Aightech/drvAMC/README.md

# drvAMC

Simple library to ..............

# Building source code

To build the project run:
```bash
cd drvAMC
mkdir build && cd build
cmake .. && make
```

# Demonstration app

When the project have been built, you can run:
```bash
./drvAMC -h
```
to get the demonstration app usage.

# Example
Open the main.cpp file to get an example how to use the lib.
