Aightech/drvAMC/docs/AMC_RS485 Communication to DZ using MC1XDZ.pdf

## RS485 Communication to DZ using MC1XDZ

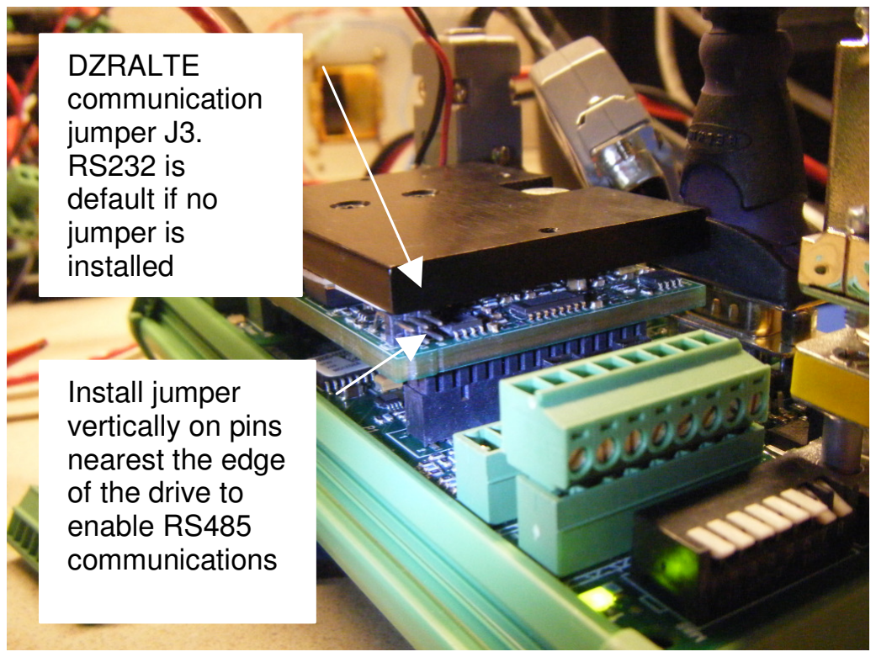
[picture p7: figure]
DZRALTE communication jumper J3. RS232 is default if no jumper is installed; Install jumper vertically on pins nearest the edge of the drive to enable RS485 communications
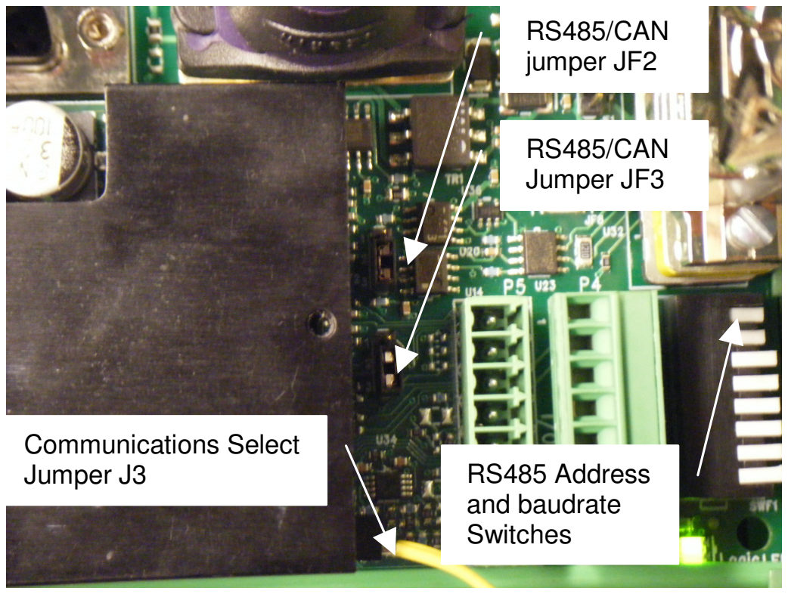
[picture p8: figure]
RS485/CAN jumper JF2; RS485/CAN Jumper JF3; Communications Select; Jumper J3; RS485 Address; and baudrate Switches
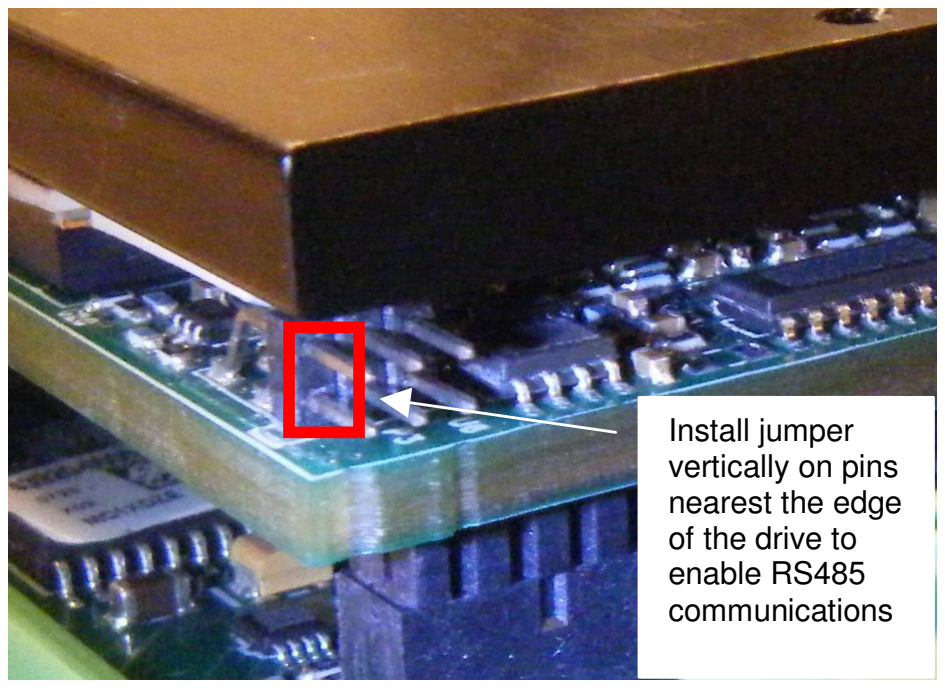
[picture p9: figure]
Install jumper vertically on pins nearest the edge of the drive to enable RS485 communications
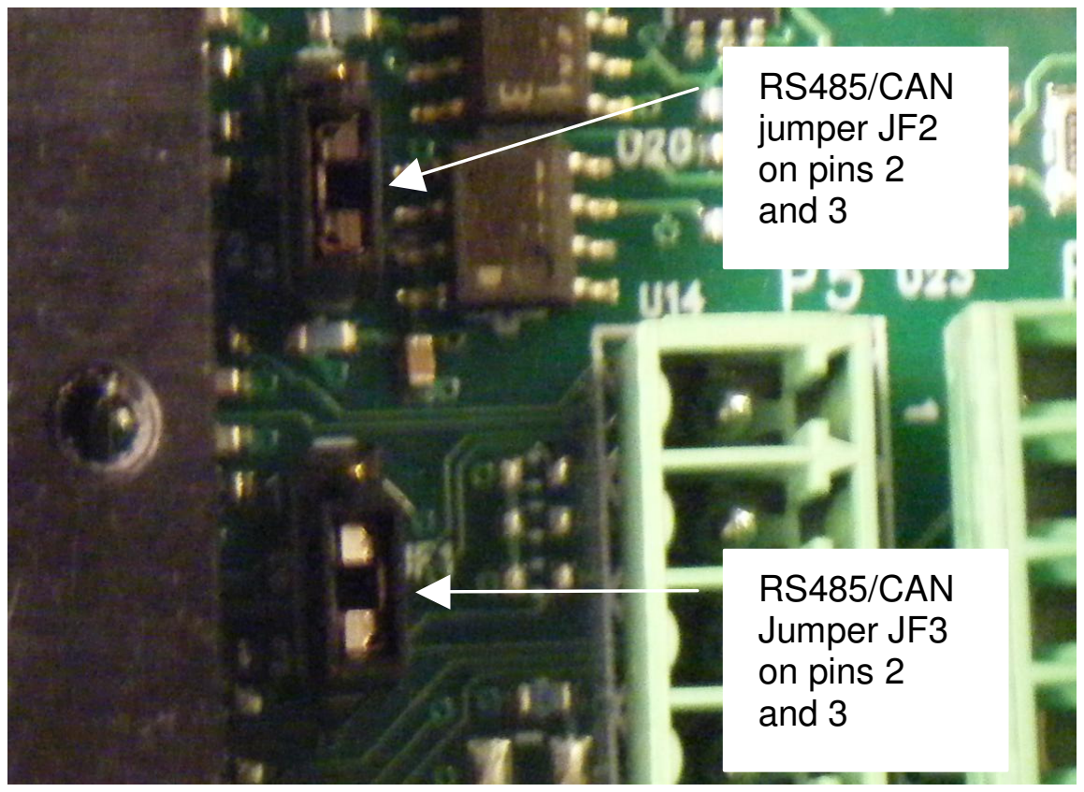
[picture p10: figure]
RS485/CAN jumper JF2 on pins 2 and 3; RS485/CAN Jumper JF3 on pins 2 and 3

Advanced Motion Controls • 3805 Calle Tecate Camarillo CA. 93012 • Tel: (805) 389-1935 • www.a-m-c.com

AN-002

## Introduction

The DZRALTE-012L080 servo drive supports RS485 communication in addition to the standard RS232 communication. The drive ships from the factory set for RS232 communication. Default communication parameters are 9600 baud and drive address
63.

## Configuring the DZRALTE for

RS485

In order for the drive to communicate via RS485, the RS485 selection jumper must be installed on the DZRALTE. The J3 jumper is pictured below on the DZRALTE mounted to a MC1XDZ.

### DZRALTE-012L080 and MC1XDZ

### Jumper Locations on MC1XDZ

Once the jumper is installed, the drive must be power cycled to enable RS485 communications. The default RS485 communication parameters are 9600 baud and address 63 respectively.

## Configuring the MC1XDZ for

RS485

The MC1XDZ mounting card must also be configured properly to support RS485 communication. The factory default is RS232 communication and CAN. To enable RS485 communication, jumpers JF2 and JF3 must be moved so that pins 2 and 3 are shorted together via the jumper. The factory default is RS232 communication with pins 1 and 2 of JF2 and JF3 shorted.

### Jumper Locations on MC1XDZ

### Jumper Settings on MC1XDZ

## RS485 Communication to DZ using MC1XDZ

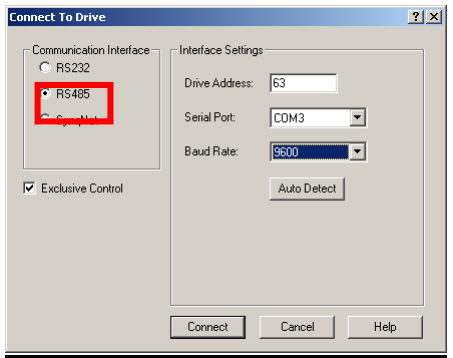
[picture p11: figure]

Advanced Motion Controls • 3805 Calle Tecate Camarillo CA. 93012 • Tel: (805) 389-1935 • www.a-m-c.com

AN-002

Unlike RS232 mode, RS485 mode supports the selection of drive address and baudrate via hardware using the switches on the MC1XDZ. The factory default is software addressing with all switches off. If switch changes are made, the drive must be power cycled before the changes will take effect.

## RS485 Connection via DriveWare

If hardware is properly configured, Drive Ware can communicate via RS485 to the drive. At the communications screen, select RS485 and make sure the drive address and baudrate match. Note: if hardware addressing and baudrate are used via the switches, make sure the values are properly entered here or communication will not work.

Once RS485 connection is established, the RS485 baudrate and drive address can be changed by pressing the connect icon on the tool bar and entering new values into the connect to drive dialog then pressing Connect.

Verify that the new baudrate took effect by looking at the bottom center of the drive ware window for connection status

Make sure to save any changes to Non-Volatile memory by using the toolbar icon or selecting Drive -> Store to Drive option from the main menu.

NOTE: The RS485 communication parameters are independent of RS232 parameters. If the drive is returned to RS232 mode, the original communication parameters that were set in RS232 mode will take affect. The factory default is to set both sets of parameters identically, but in practice it is possible to have two different sets of parameters.
