Aightech/drvAMC/models/v2/Assem1.SLDASM

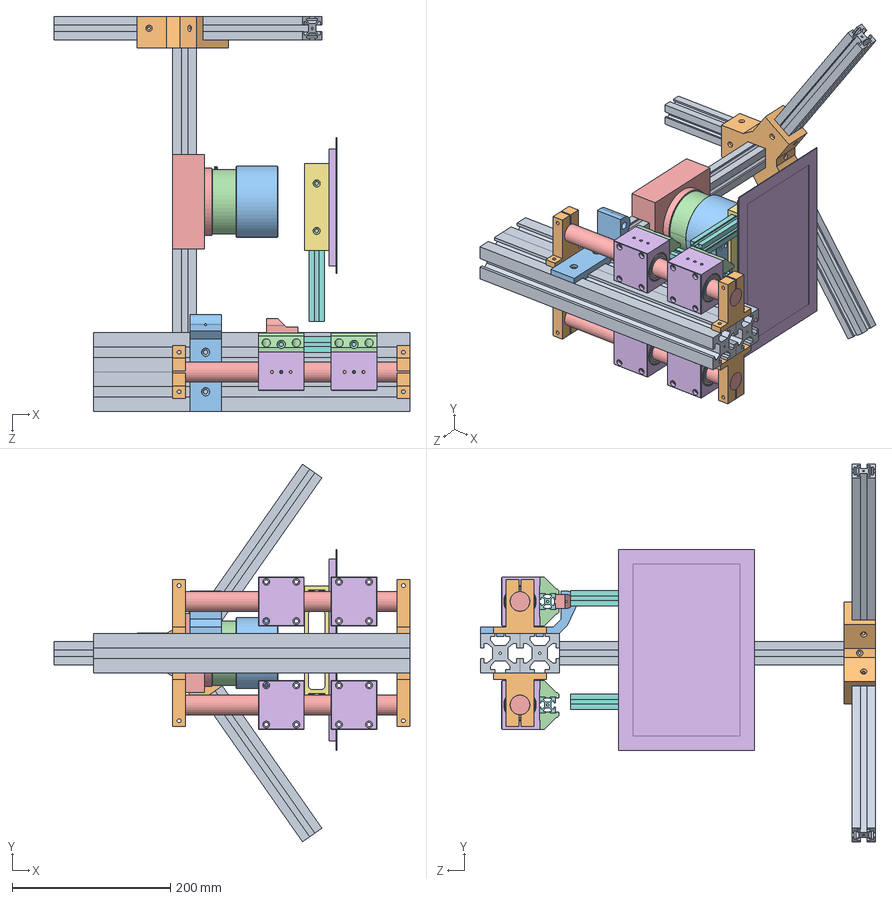
[picture p30: CAD file, 2022-02-02, last stored version]
models/v2/Assem1.SLDASM
450.0 x 478.0 x 500.0 mm
profile30 x 4
foot_link
AVM90-30-core-Sketch.STEP
AVM90-30-Coil-Sketch.STEP
shaft x 2
S8025P02.step x 4
S3025021.step x 4
S3025022.step x 4
S3025023.step x 4
S3025024.step x 4
S3025025.step x 4
S3025026.step x 4
Part15^Assem1
screen
screenHolder
profile20 x 4
profile50 x 2
guide_holder x 4
lvdt_holderSLDPRT
bracke-holder-v2 x 8
lvdt_holderP2
