Aightech/drvAMC/models/voice_coil.SLDASM

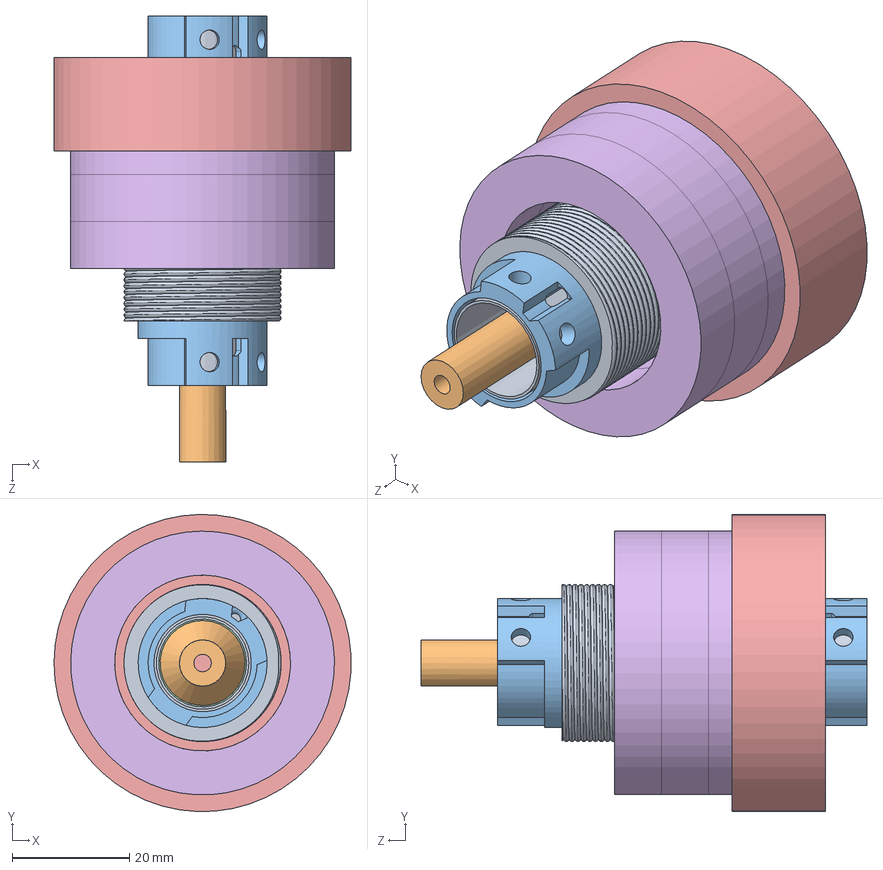
[picture p31: CAD file, 2022-02-02, last stored version]
models/voice_coil.SLDASM
50.7 x 50.7 x 76.0 mm
solenoid
magnet
coil_end x 2
mag x 4
magnet_holder
magnet_large x 4
