Aightech/drvAMC/models/Assem1.SLDASM

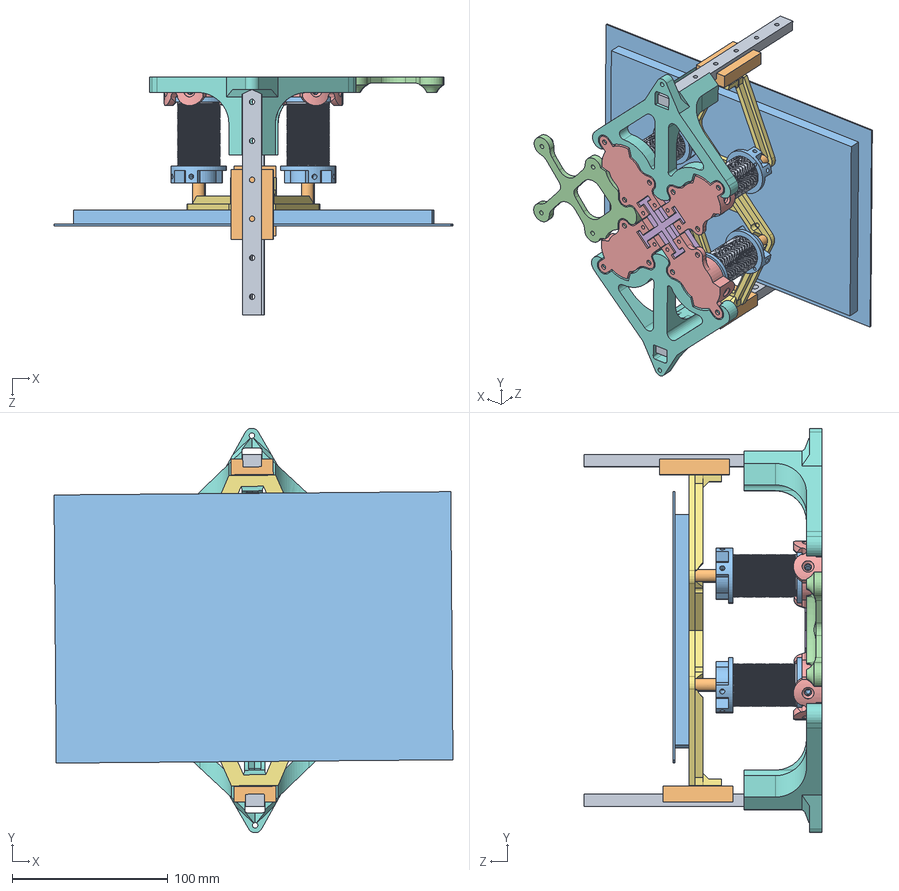
[picture p32: CAD file, 2022-02-02, last stored version]
models/Assem1.SLDASM
255.9 x 259.4 x 152.8 mm
solenoid x 4
magnet x 4
coil_end x 8
mag x 16
coil_holder x 4
frame
screen_holder
guide x 2
slide_guide x 2
slider x 2
screen
rpy_linkv2
