Aightech/drvAMC/models/v2/Assem2.SLDASM

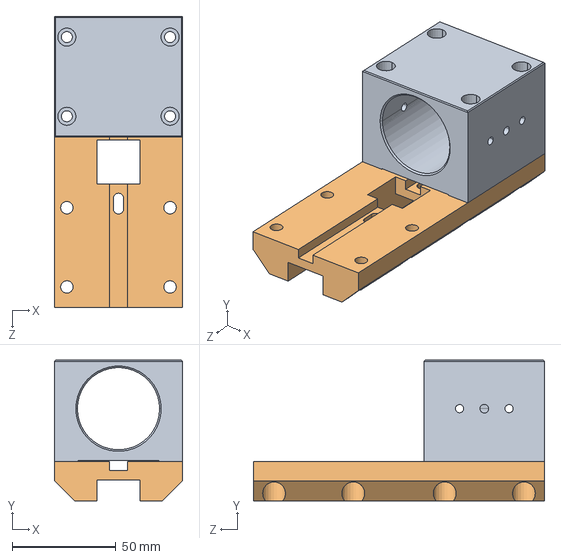
[picture p33: CAD file, 2022-02-02, last stored version]
models/v2/Assem2.SLDASM
61.7 x 67.6 x 140.0 mm
S8025P02
bracke-holder
