Aightech/drvAMC/models/new/magnet_holder.SLDPRT

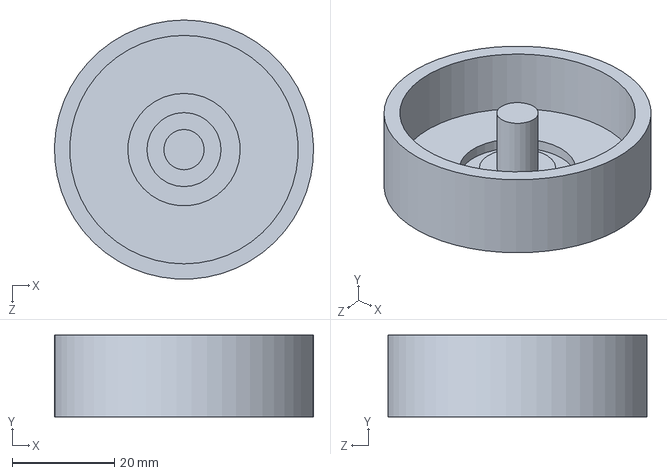
[picture p34: CAD file, 2022-02-02, last stored version]
models/new/magnet_holder.SLDPRT
50.7 x 16.0 x 50.7 mm
