Aightech/drvAMC/models/slider.SLDPRT

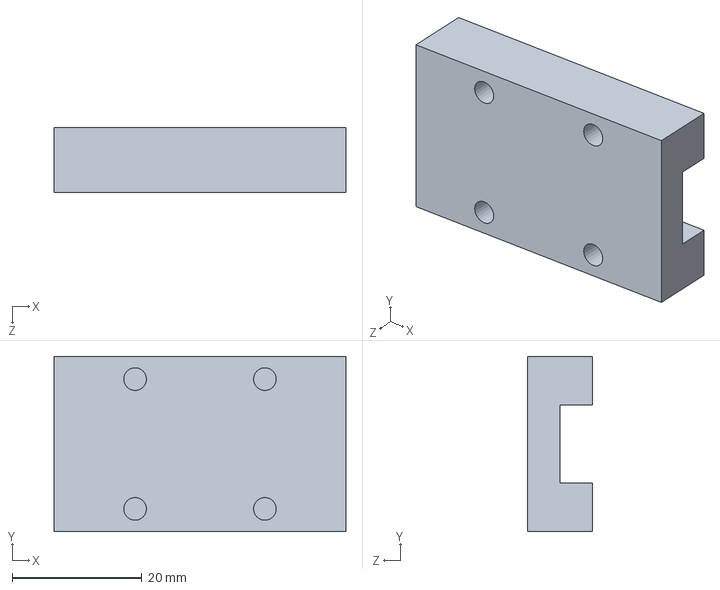
[picture p35: CAD file, 2022-02-02, last stored version]
models/slider.SLDPRT
45.0 x 27.0 x 10.0 mm
