Aightech/drvAMC/models/v2/screen.SLDPRT

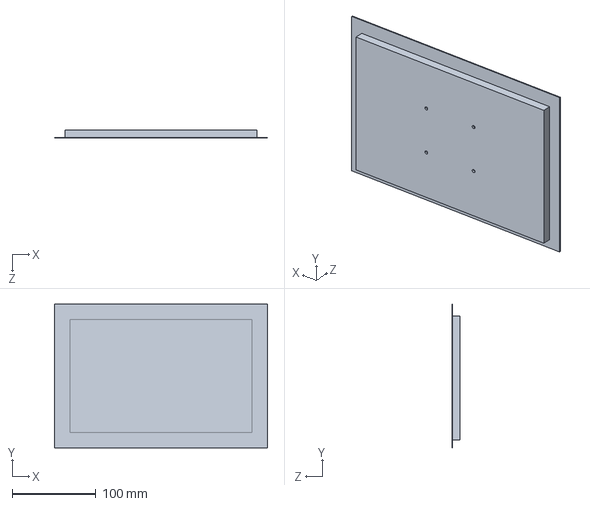
[picture p36: CAD file, 2022-02-02, last stored version]
models/v2/screen.SLDPRT
254.5 x 172.0 x 10.0 mm
