Aightech/drvAMC/models/mag.SLDPRT

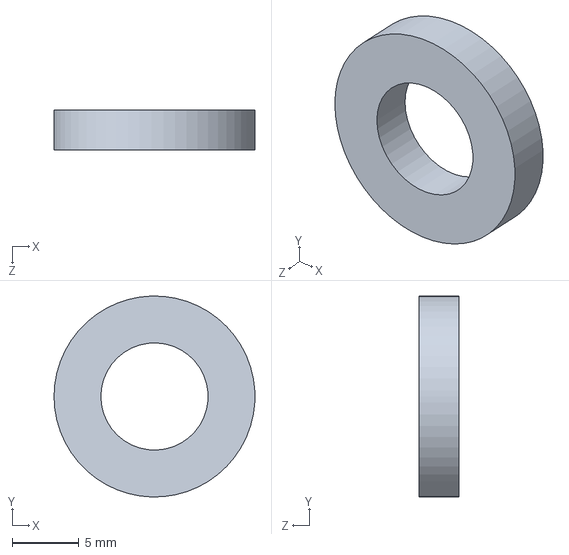
[picture p37: CAD file, 2022-02-02, last stored version]
models/mag.SLDPRT
15.0 x 15.0 x 3.00 mm
