Aightech/drvAMC/models/v2/end mount.SLDPRT

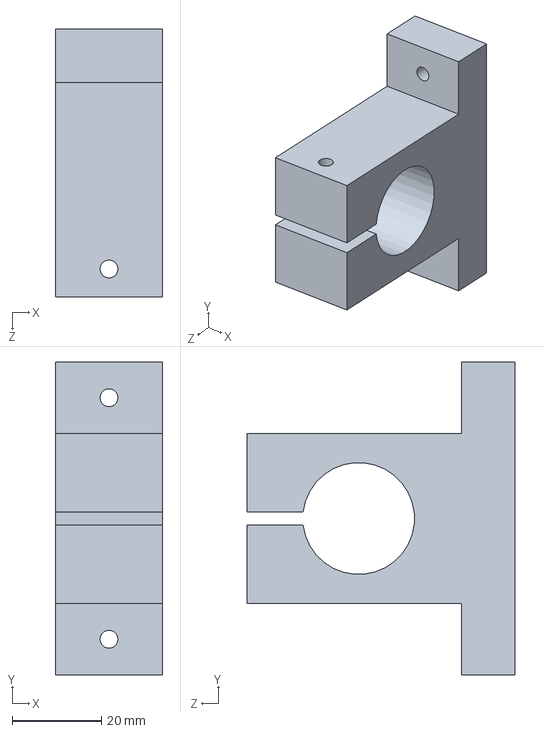
[picture p38: CAD file, 2022-02-02, last stored version]
models/v2/end mount.SLDPRT
24.0 x 70.0 x 60.0 mm
