Aightech/drvAMC/models/coil_end.SLDPRT

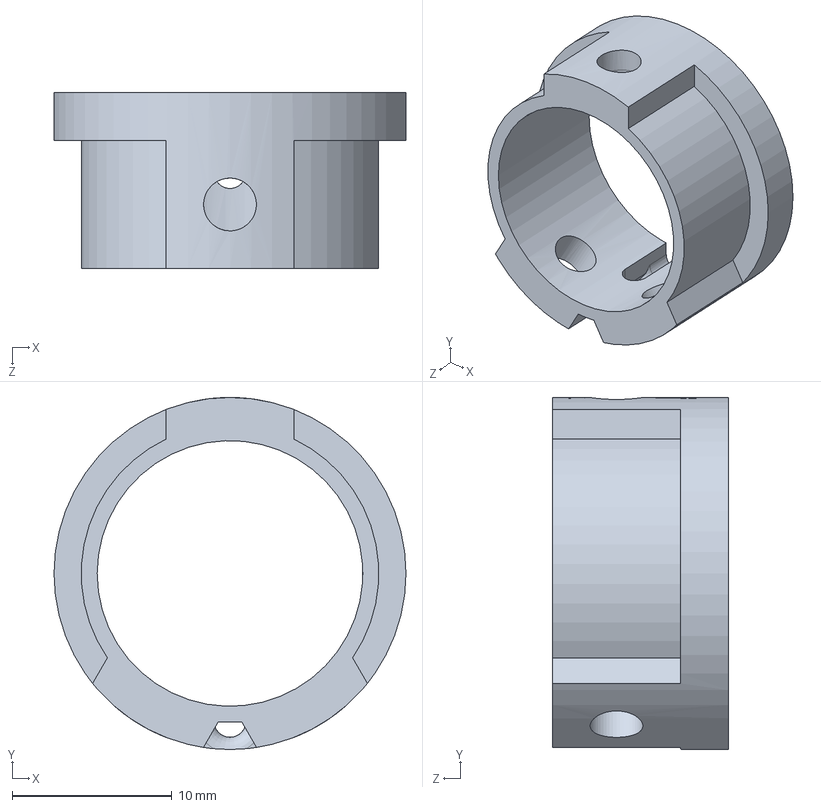
[picture p39: CAD file, 2022-02-02, last stored version]
models/coil_end.SLDPRT
22.0 x 22.0 x 11.0 mm
