Aightech/drvAMC/models/v2/lvdt_holderSLDPRT.SLDPRT

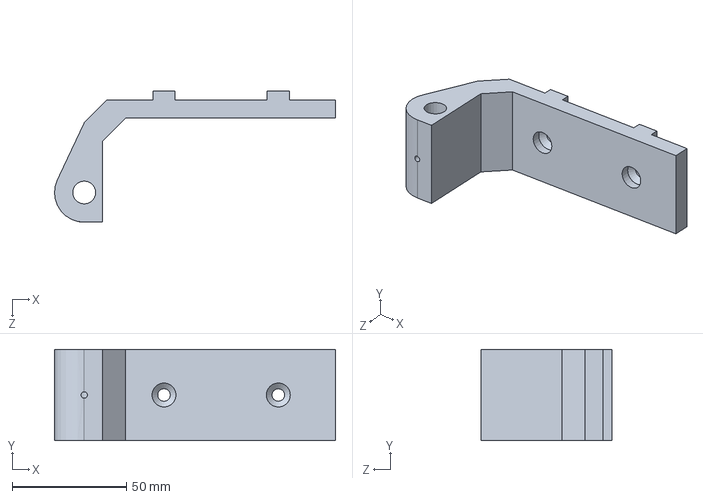
[picture p40: CAD file, 2022-02-02, last stored version]
models/v2/lvdt_holderSLDPRT.SLDPRT
122.9 x 40.0 x 57.5 mm
