Aightech/drvAMC/models/irsensor_cache.SLDPRT

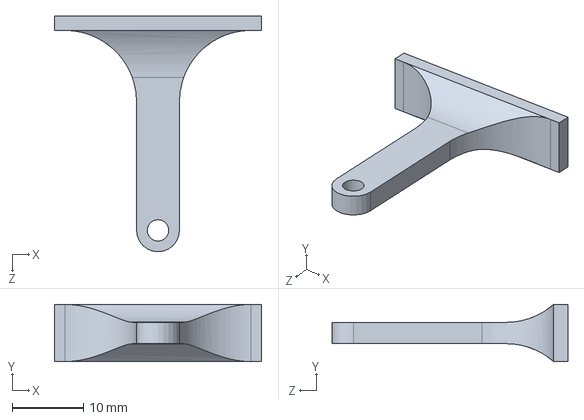
[picture p41: CAD file, 2022-02-02, last stored version]
models/irsensor_cache.SLDPRT
29.0 x 8.00 x 33.0 mm
