Aightech/drvAMC/models/v2/S8025E02.STEP

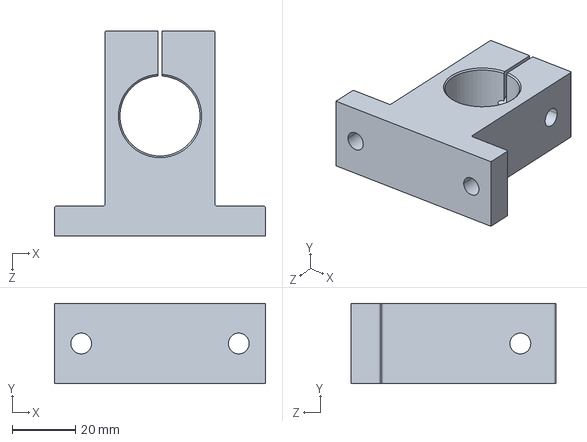
[picture p42: CAD file, 2022-02-02, last stored version]
models/v2/S8025E02.STEP
67.0 x 25.4 x 65.1 mm
