Aightech/drvAMC/models/screen_holder.SLDPRT

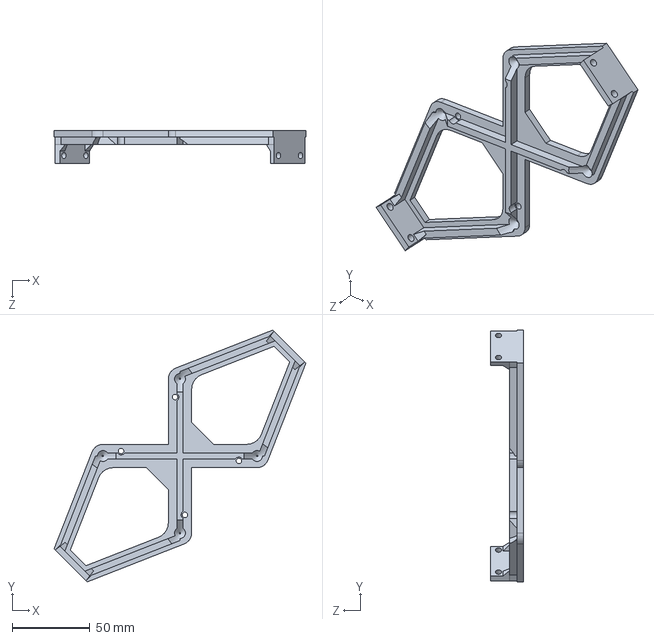
[picture p43: CAD file, 2022-02-02, last stored version]
models/screen_holder.SLDPRT
161.9 x 161.9 x 21.0 mm
