Aightech/drvAMC/models/v2/screenHolderV2_right.STL

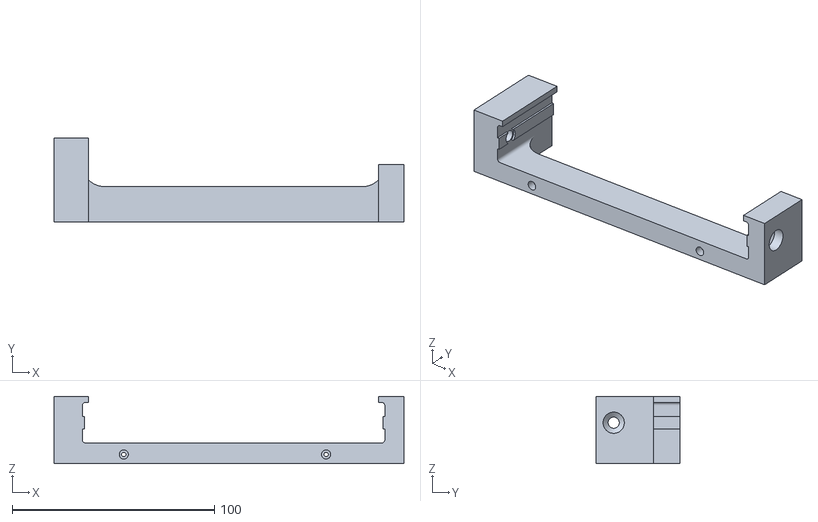
[picture p44: CAD file, 2022-02-02, last stored version]
models/v2/screenHolderV2_right.STL
173.0 x 41.5 x 33.2
