Aightech/drvAMC/models/irsensor_tube.SLDPRT

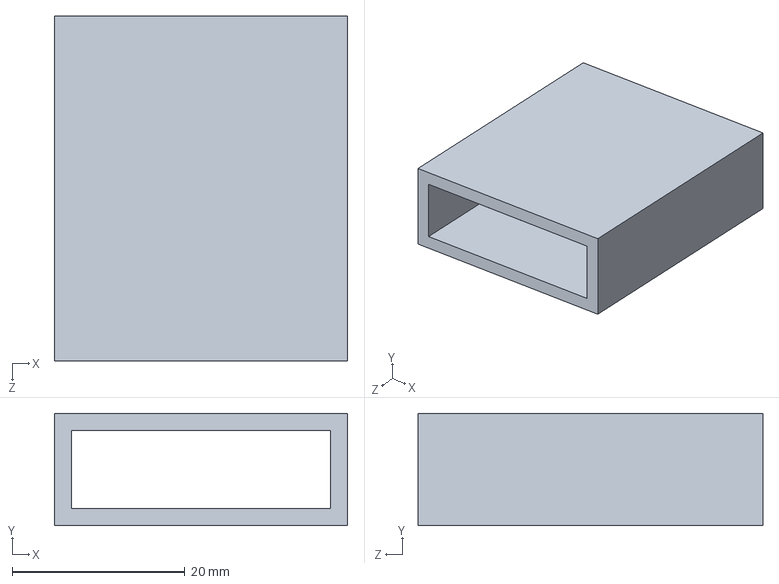
[picture p45: CAD file, 2022-02-02, last stored version]
models/irsensor_tube.SLDPRT
34.0 x 13.0 x 40.0 mm
