Aightech/drvAMC/models/v2/profile40.SLDPRT

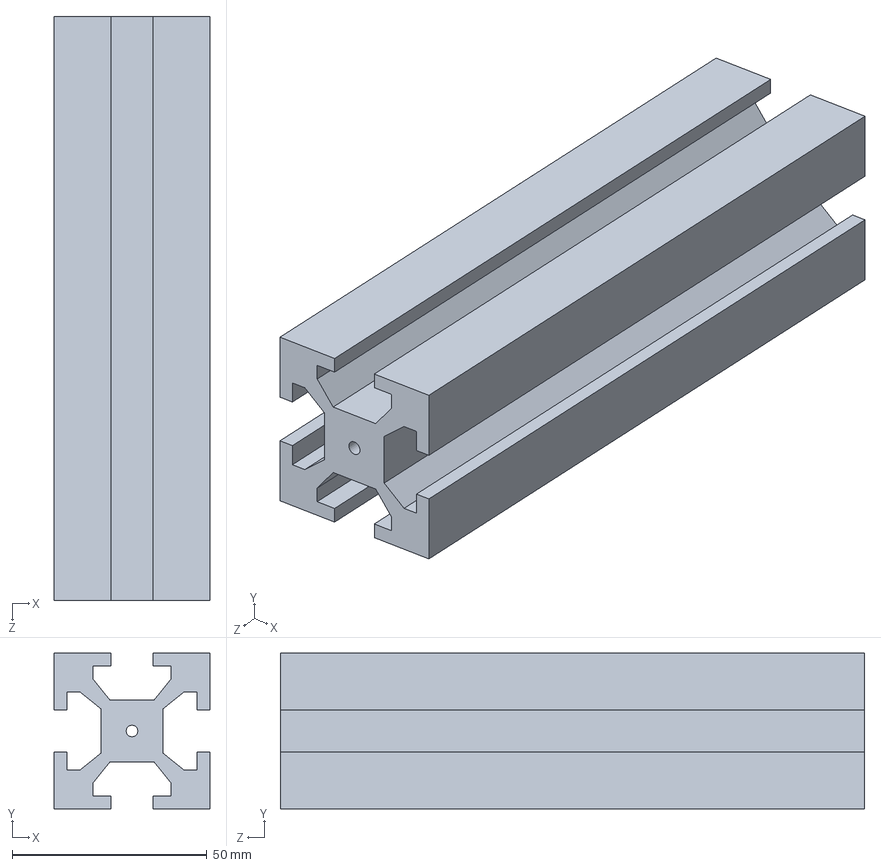
[picture p46: CAD file, 2022-02-02, last stored version]
models/v2/profile40.SLDPRT
40.0 x 40.0 x 150.0 mm
