Aightech/drvAMC/models/rpy_supp.SLDPRT

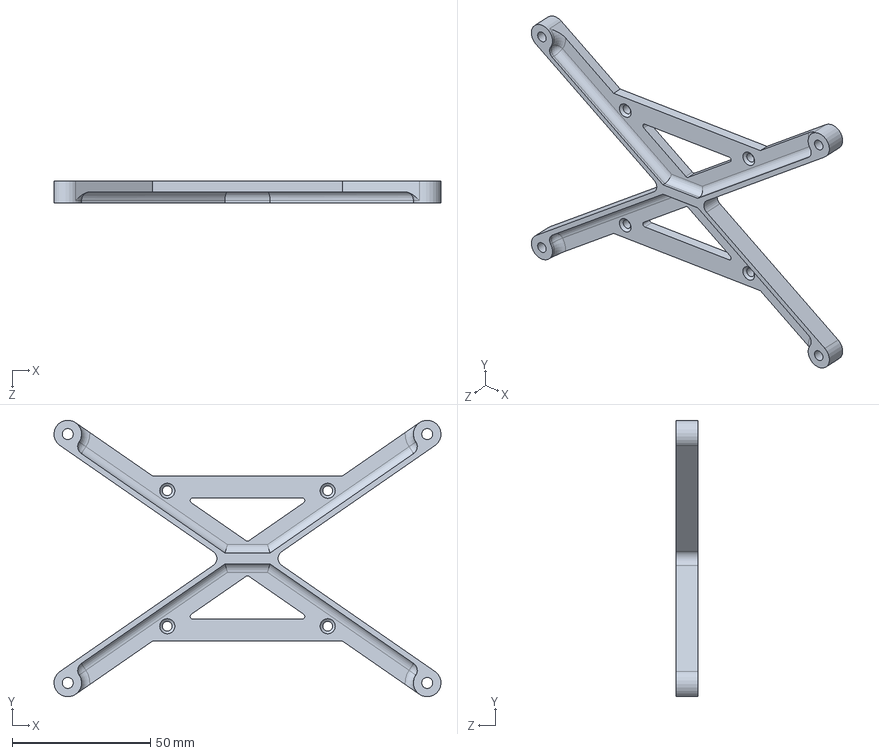
[picture p47: CAD file, 2022-02-02, last stored version]
models/rpy_supp.SLDPRT
140.0 x 100.0 x 8.00 mm
