Aightech/drvAMC/models/v2/screenDriverHolder.SLDPRT

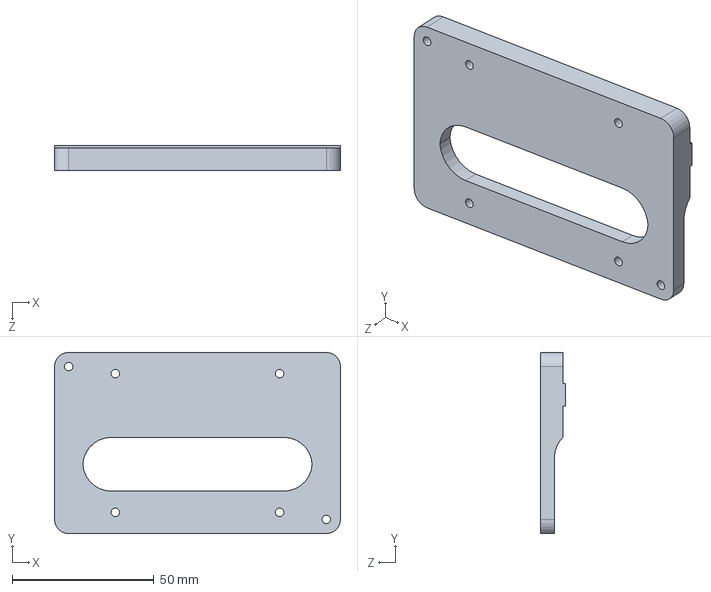
[picture p48: CAD file, 2022-02-02, last stored version]
models/v2/screenDriverHolder.SLDPRT
101.0 x 64.0 x 9.00 mm
