Aightech/drvAMC/models/magnet_large.SLDPRT

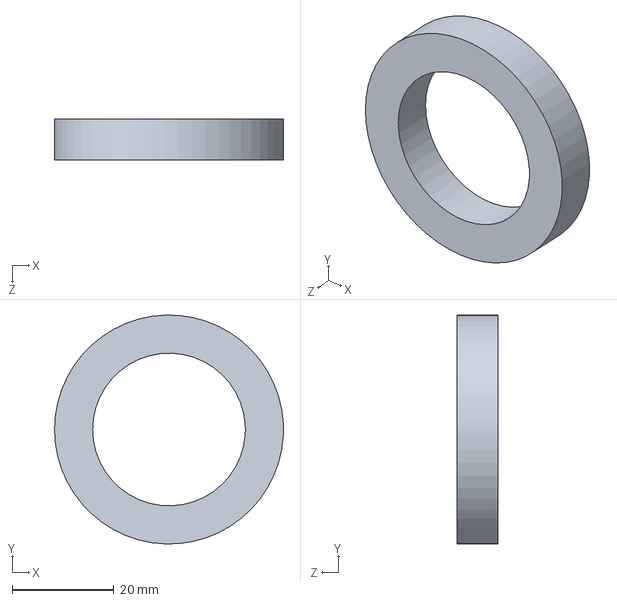
[picture p49: CAD file, 2022-02-02, last stored version]
models/magnet_large.SLDPRT
45.0 x 45.0 x 8.00 mm
