Aightech/drvAMC/models/v2/shaft.SLDPRT

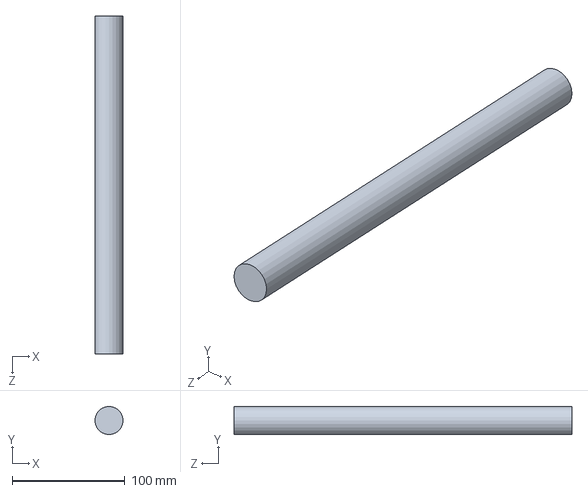
[picture p50: CAD file, 2022-02-02, last stored version]
models/v2/shaft.SLDPRT
25.0 x 25.0 x 300.0 mm
