Aightech/drvAMC/models/solenoid.SLDPRT

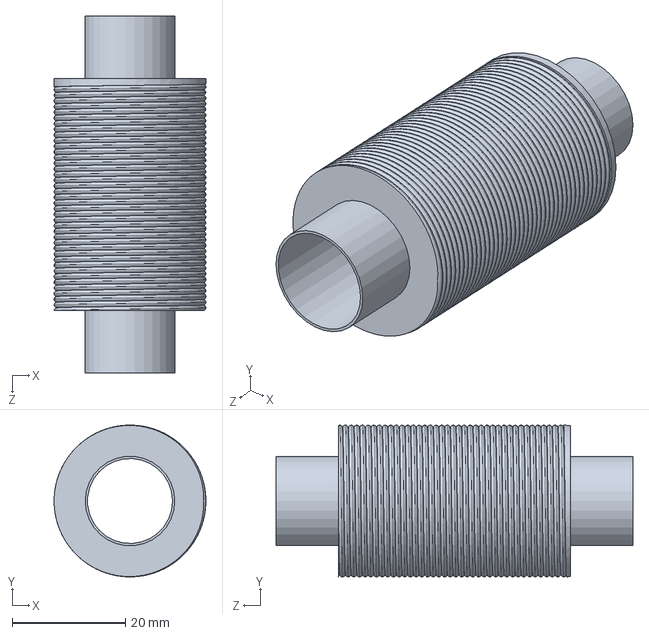
[picture p51: CAD file, 2022-02-02, last stored version]
models/solenoid.SLDPRT
26.8 x 26.8 x 63.0 mm
