Aightech/drvAMC/models/v2/motorMovingHolder.SLDPRT

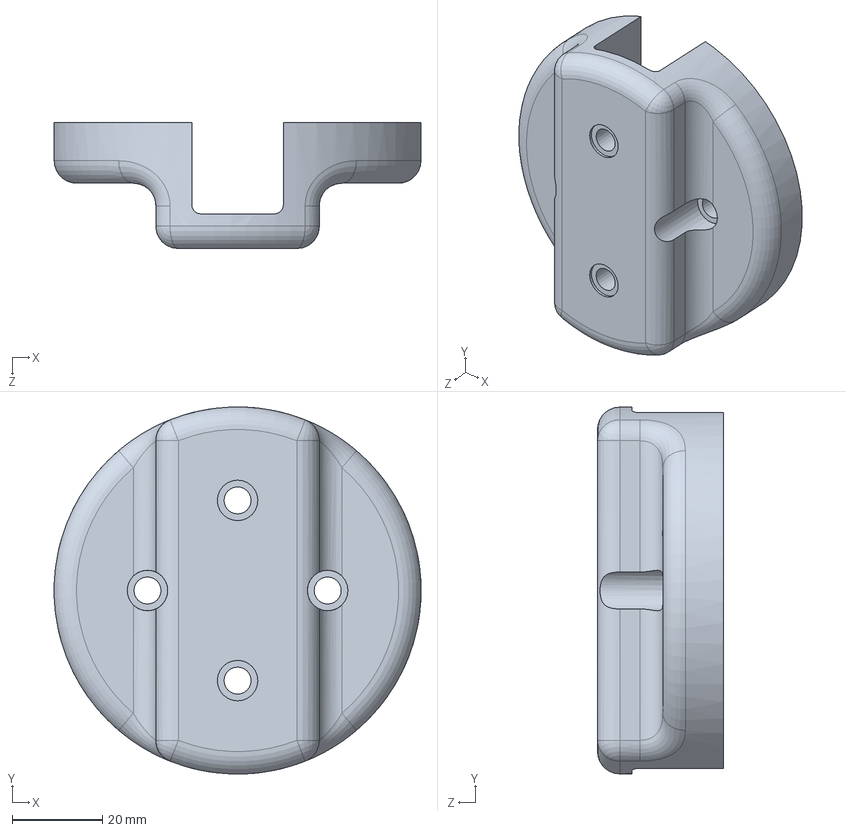
[picture p52: CAD file, 2022-02-02, last stored version]
models/v2/motorMovingHolder.SLDPRT
81.5 x 81.5 x 28.0 mm
