Aightech/drvAMC/models/rpy_link.SLDPRT

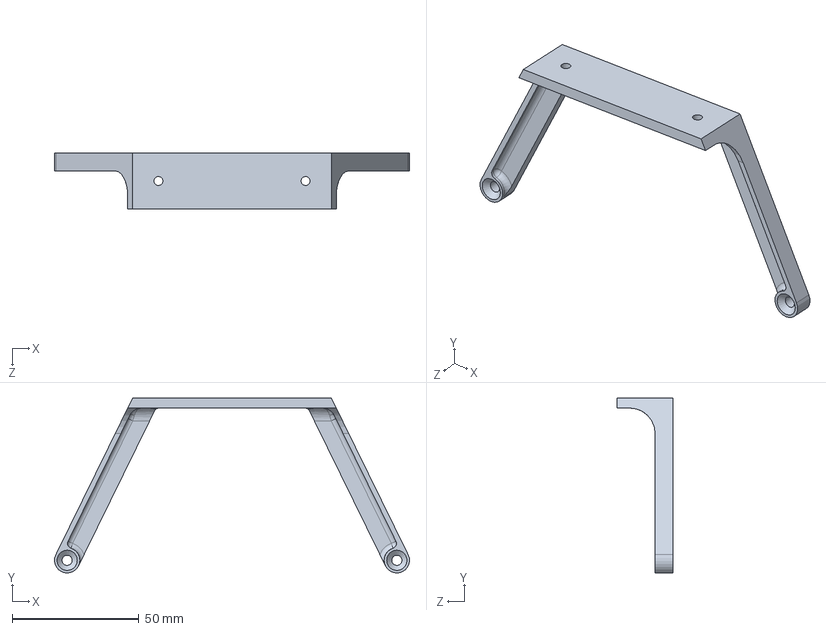
[picture p54: CAD file, 2022-02-02, last stored version]
models/rpy_link.SLDPRT
140.0 x 69.0 x 22.0 mm
