Aightech/drvAMC/models/v2/screenHolder.SLDPRT

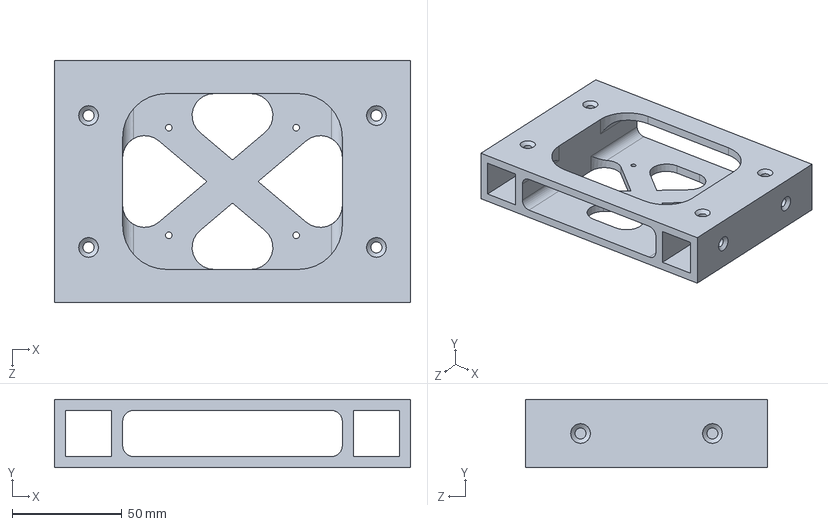
[picture p55: CAD file, 2022-02-02, last stored version]
models/v2/screenHolder.SLDPRT
162.0 x 31.0 x 110.0 mm
