Aightech/drvAMC/models/v2/foot_link.SLDPRT

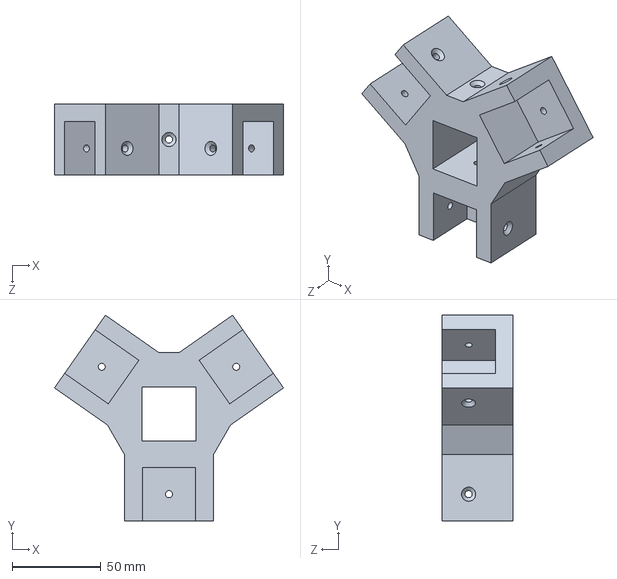
[picture p56: CAD file, 2022-02-02, last stored version]
models/v2/foot_link.SLDPRT
129.0 x 115.9 x 40.0 mm
