Aightech/drvAMC/models/guide.SLDPRT

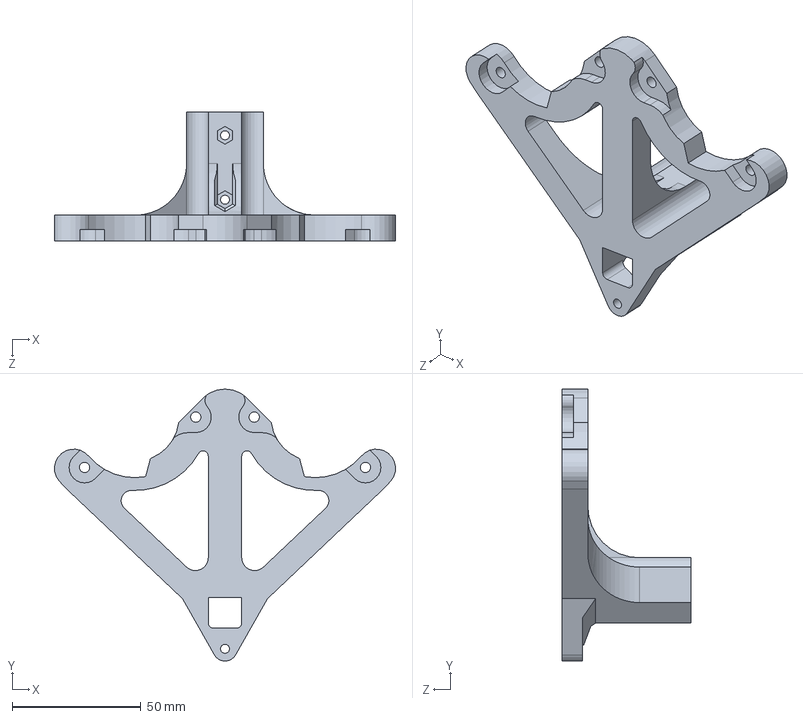
[picture p57: CAD file, 2022-02-02, last stored version]
models/guide.SLDPRT
132.4 x 105.6 x 50.0 mm
