Aightech/drvAMC/models/v2/screenHolderV2_left.STL

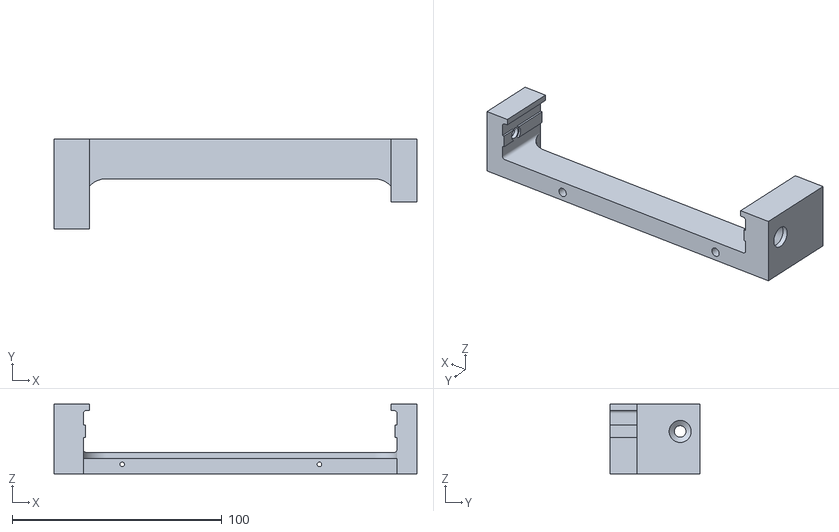
[picture p58: CAD file, 2022-02-02, last stored version]
models/v2/screenHolderV2_left.STL
173.0 x 43.0 x 33.2
