Aightech/drvAMC/models/rpy_linkv2.SLDPRT

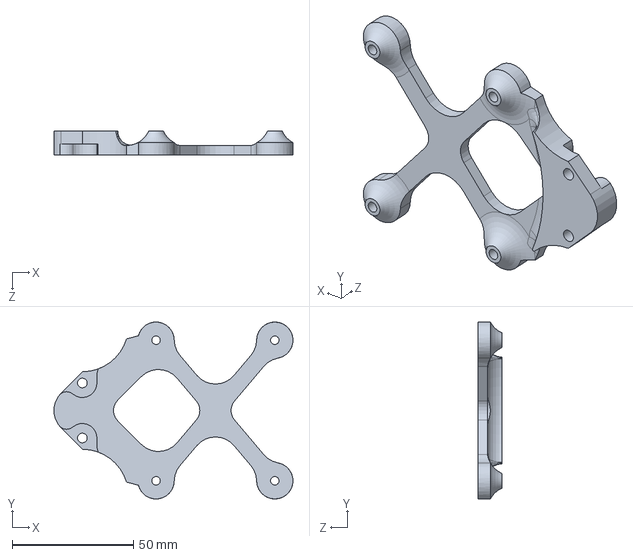
[picture p59: CAD file, 2022-02-02, last stored version]
models/rpy_linkv2.SLDPRT
98.6 x 73.0 x 10.0 mm
