Aightech/drvAMC/models/v2/driverHolder.SLDPRT

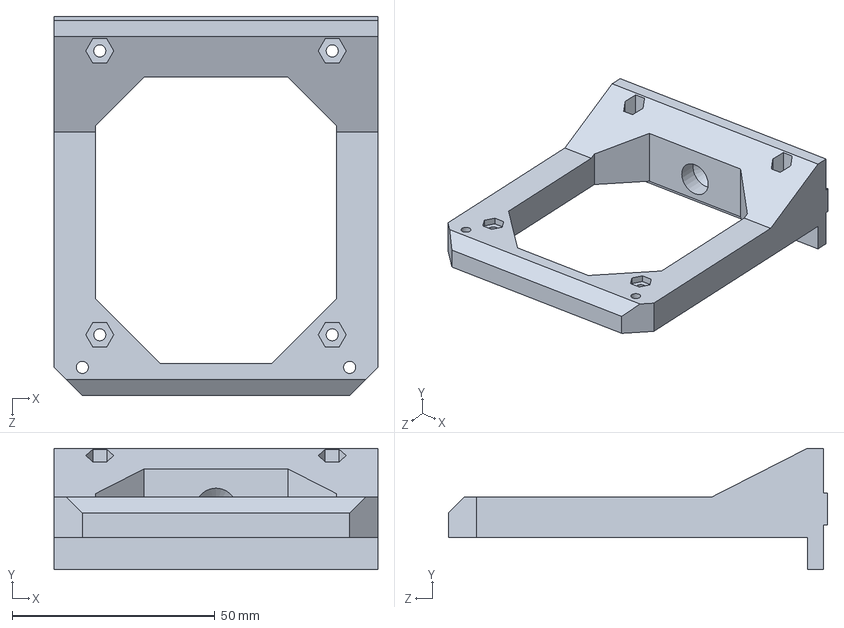
[picture p60: CAD file, 2022-02-02, last stored version]
models/v2/driverHolder.SLDPRT
80.0 x 30.0 x 93.7 mm
