Aightech/drvAMC/models/ir_top.SLDPRT

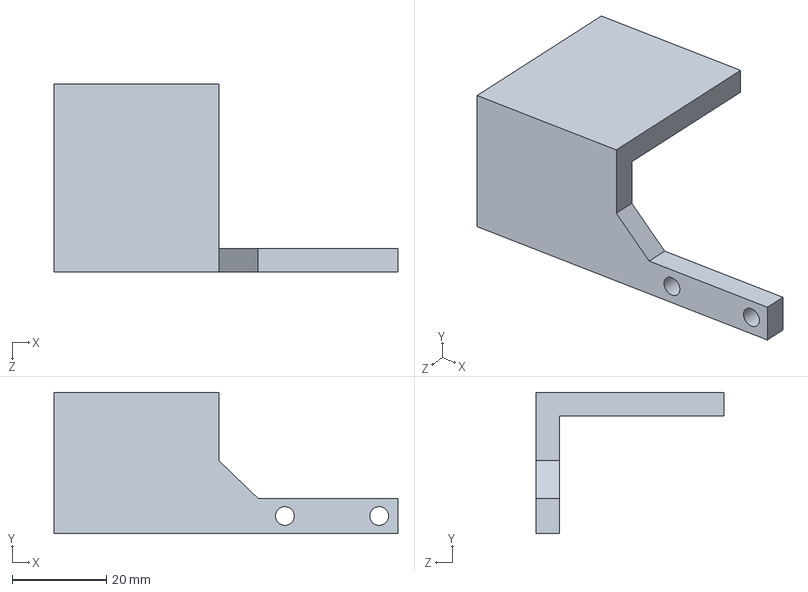
[picture p61: CAD file, 2022-02-02, last stored version]
models/ir_top.SLDPRT
73.0 x 30.0 x 40.0 mm
