Aightech/drvAMC/models/v2/bracket.SLDPRT

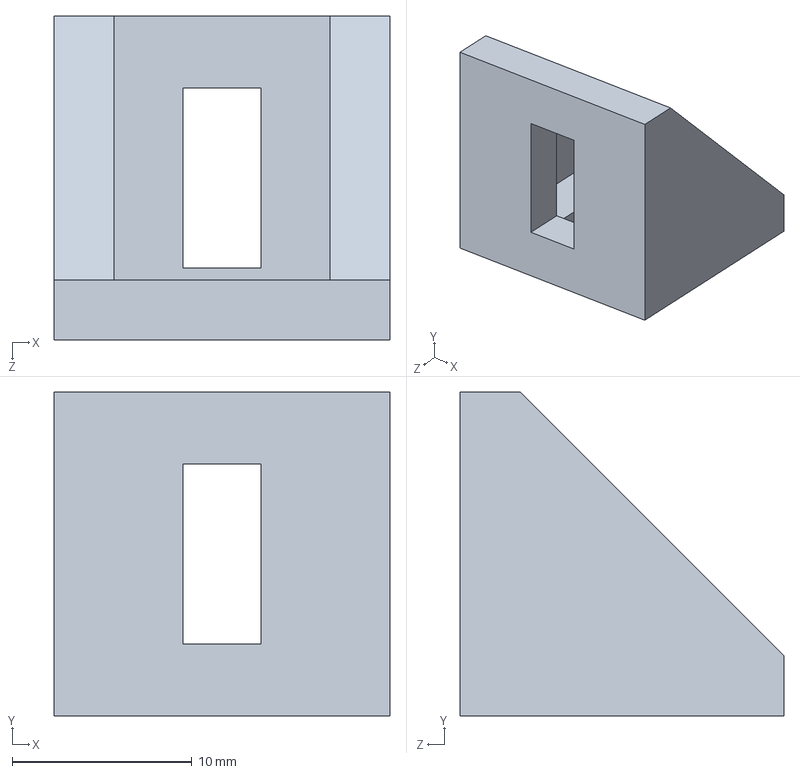
[picture p62: CAD file, 2022-02-02, last stored version]
models/v2/bracket.SLDPRT
18.7 x 18.0 x 18.0 mm
