Aightech/drvAMC/models/frame.SLDPRT

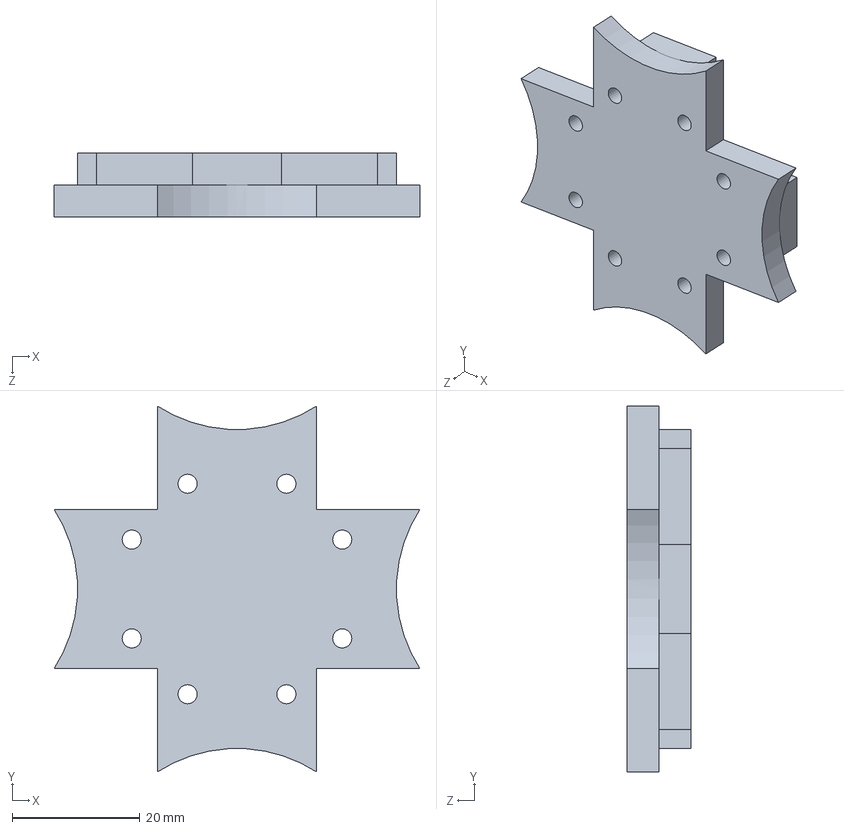
[picture p63: CAD file, 2022-02-02, last stored version]
models/frame.SLDPRT
57.4 x 57.4 x 10.0 mm
