Aightech/drvAMC/models/v2/screenHolderV2.SLDPRT

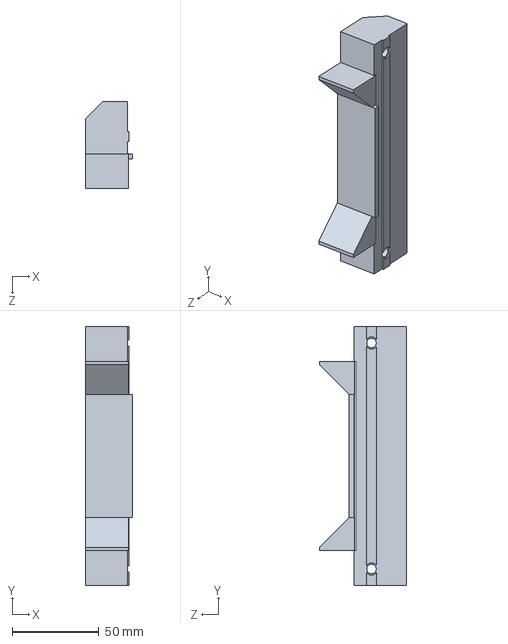
[picture p64: CAD file, 2022-02-02, last stored version]
models/v2/screenHolderV2.SLDPRT
27.0 x 149.0 x 50.2 mm
