Aightech/drvAMC/models/v2/profile50.SLDPRT

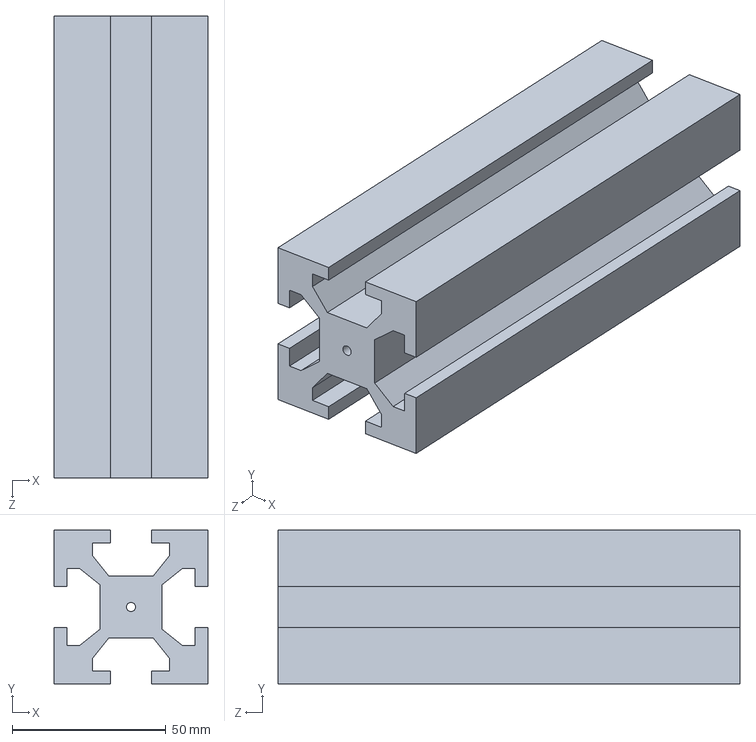
[picture p65: CAD file, 2022-02-02, last stored version]
models/v2/profile50.SLDPRT
50.0 x 50.0 x 150.0 mm
