Aightech/drvAMC/models/coil_holder.SLDPRT

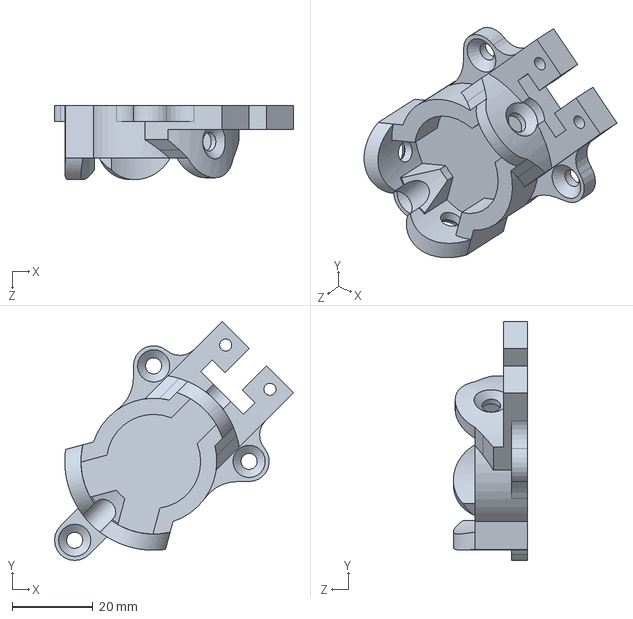
[picture p66: CAD file, 2022-02-02, last stored version]
models/coil_holder.SLDPRT
59.2 x 59.2 x 18.4 mm
