Aightech/drvAMC/models/v2/motorHolder.SLDPRT

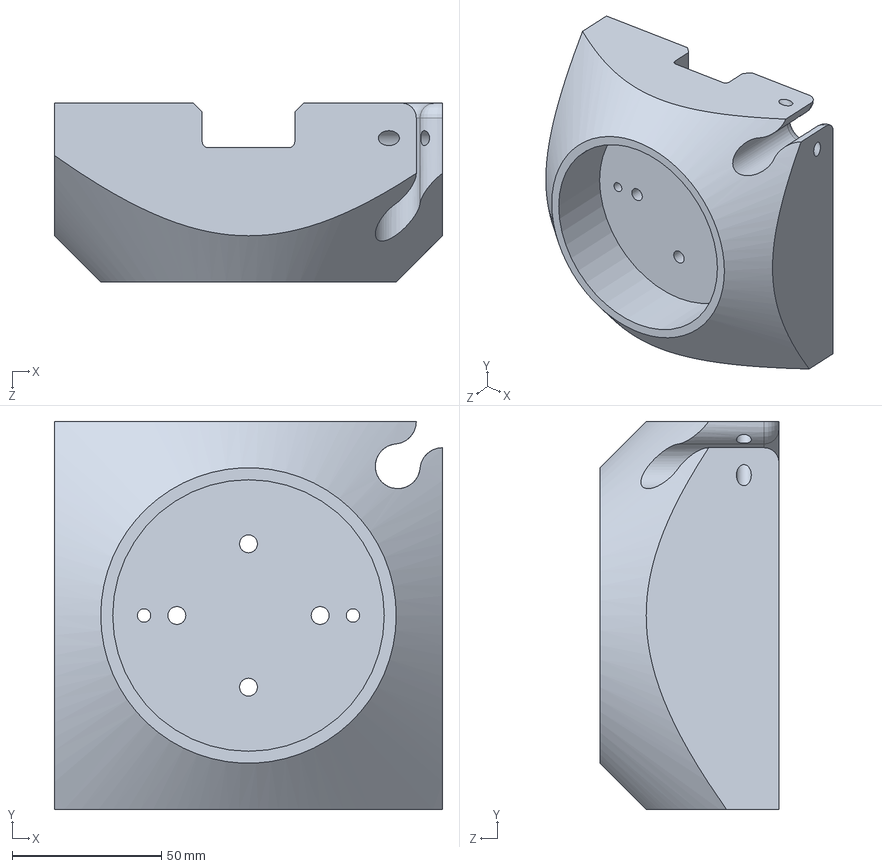
[picture p67: CAD file, 2022-02-02, last stored version]
models/v2/motorHolder.SLDPRT
130.0 x 130.0 x 60.0 mm
