Aightech/drvAMC/models/slide_guide.SLDPRT

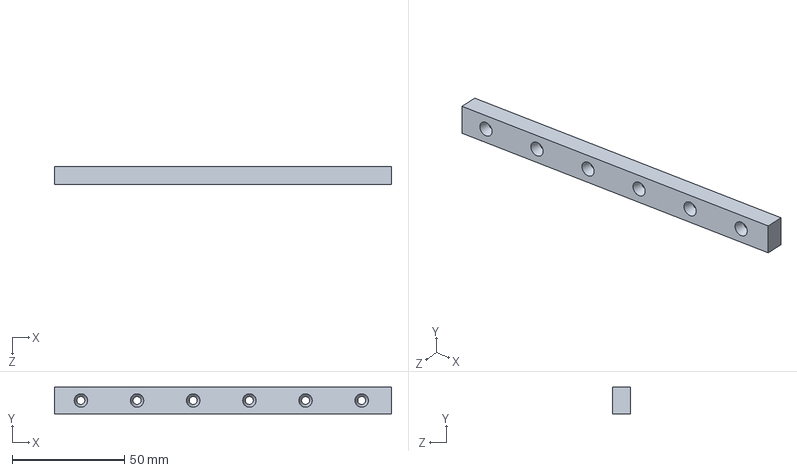
[picture p68: CAD file, 2022-02-02, last stored version]
models/slide_guide.SLDPRT
150.0 x 12.0 x 8.00 mm
