Aightech/drvAMC/models/v2/AVM90-30.STEP

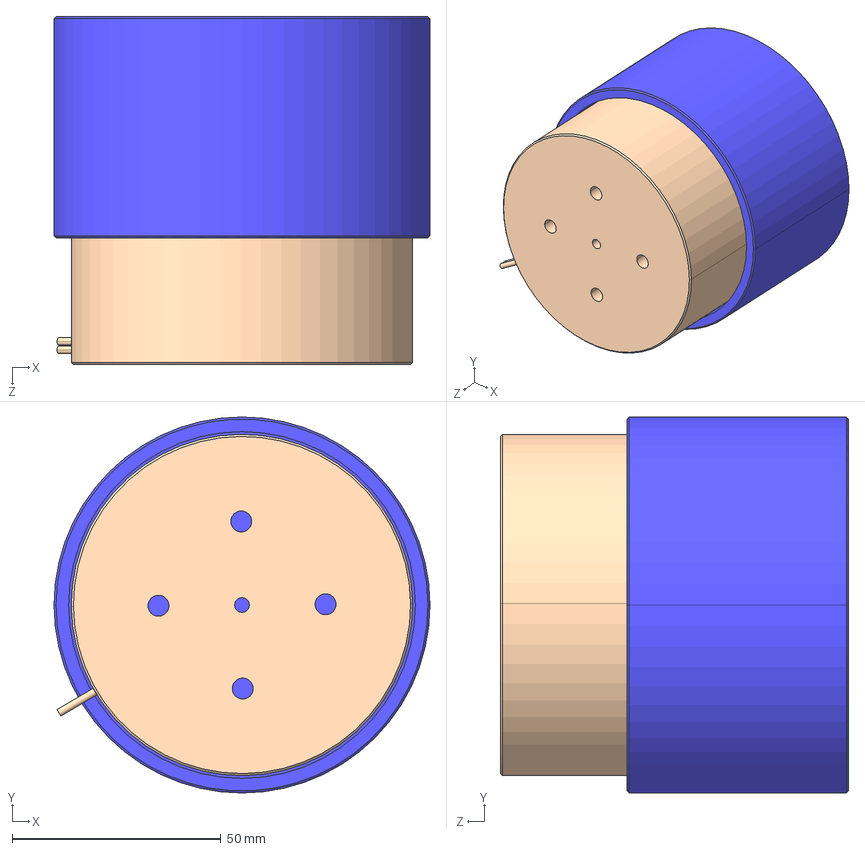
[picture p69: CAD file, 2022-02-02, last stored version]
models/v2/AVM90-30.STEP
90.0 x 90.0 x 83.3 mm
AVM90-30-core-Sketch
AVM90-30-Coil-Sketch
