Aightech/drvAMC/models/magnet.SLDPRT

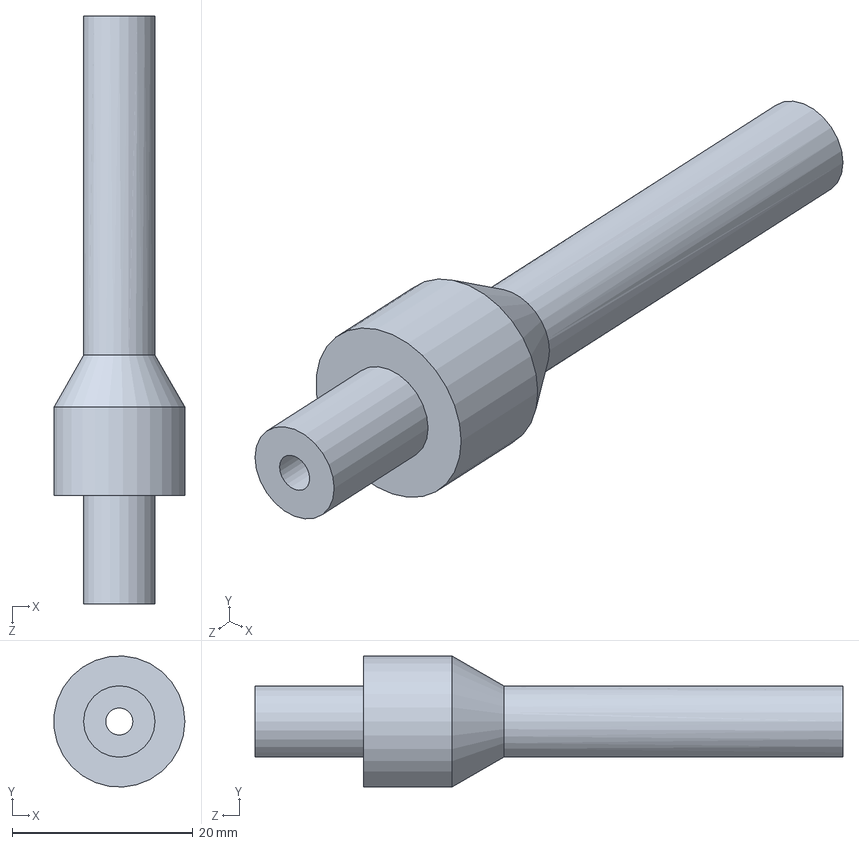
[picture p70: CAD file, 2022-02-02, last stored version]
models/magnet.SLDPRT
14.5 x 14.5 x 65.0 mm
