Aightech/drvAMC/models/v2/bracke-holder-v2.SLDPRT

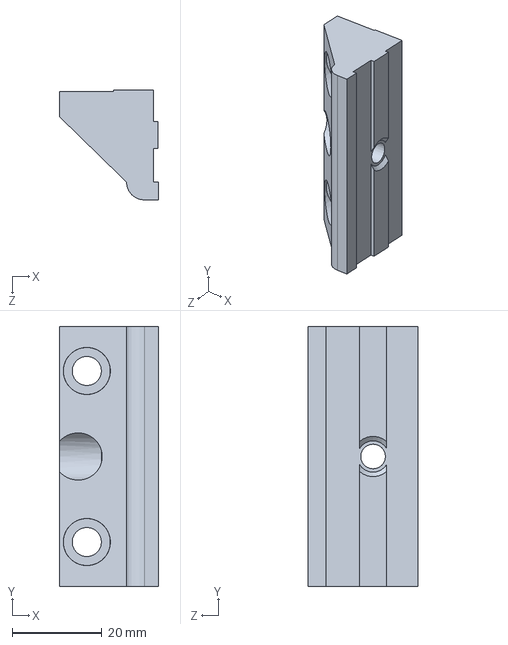
[picture p71: CAD file, 2022-02-02, last stored version]
models/v2/bracke-holder-v2.SLDPRT
22.0 x 57.9 x 24.5 mm
