Aightech/drvAMC/models/v2/carter.SLDPRT

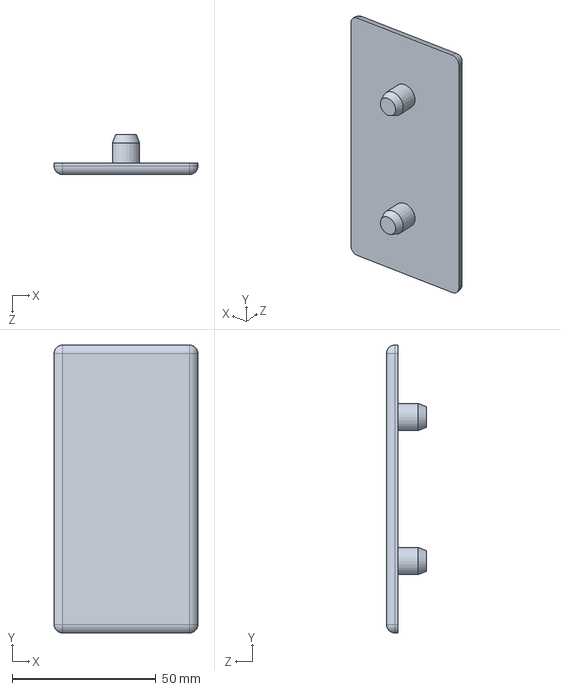
[picture p72: CAD file, 2022-02-02, last stored version]
models/v2/carter.SLDPRT
50.0 x 100.0 x 14.0 mm
