Aightech/drvAMC/models/v2/bracke-holder.SLDPRT

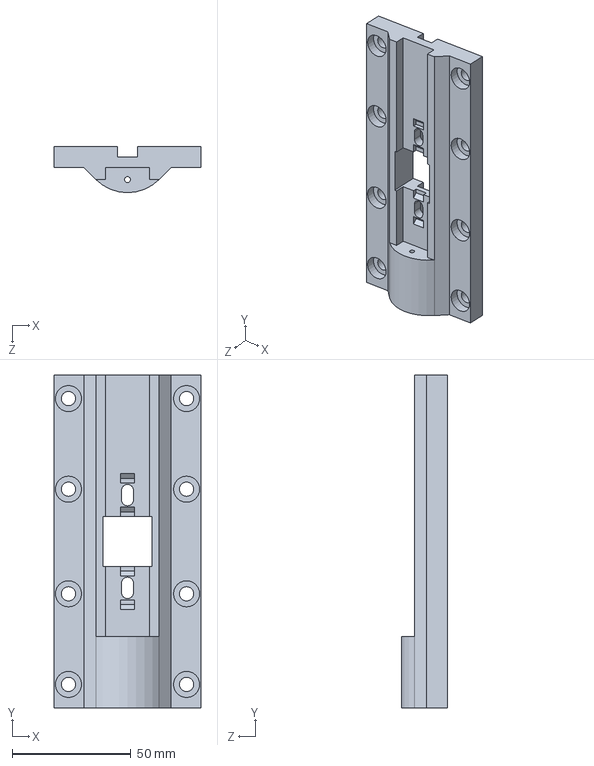
[picture p73: CAD file, 2022-02-02, last stored version]
models/v2/bracke-holder.SLDPRT
61.7 x 140.0 x 19.5 mm
