Aightech/drvAMC/models/v2/guide_holder.SLDPRT

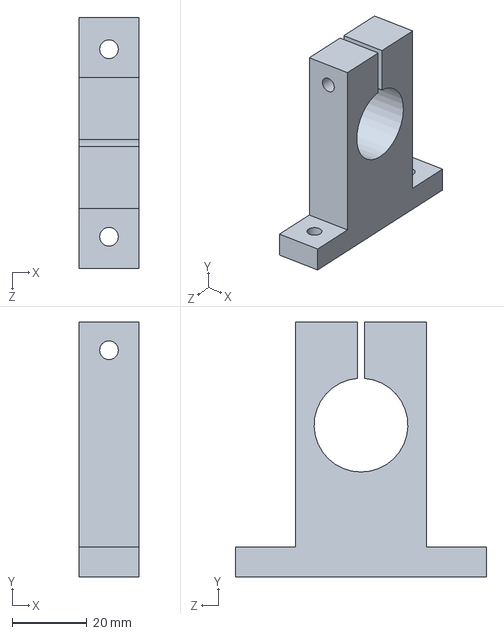
[picture p74: CAD file, 2022-02-02, last stored version]
models/v2/guide_holder.SLDPRT
16.0 x 68.0 x 67.0 mm
