Aightech/drvAMC/models/v2/block_link.SLDPRT

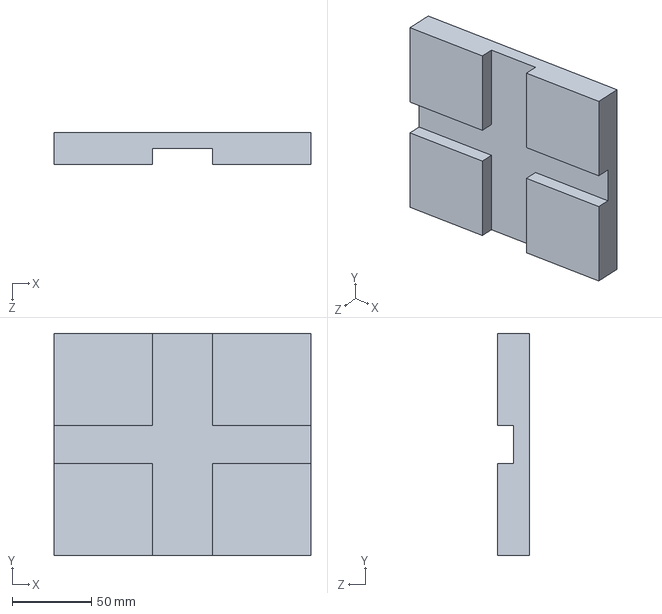
[picture p75: CAD file, 2022-02-02, last stored version]
models/v2/block_link.SLDPRT
161.7 x 140.0 x 20.0 mm
