Aightech/drvAMC/models/v2/lvdt_holderP2.SLDPRT

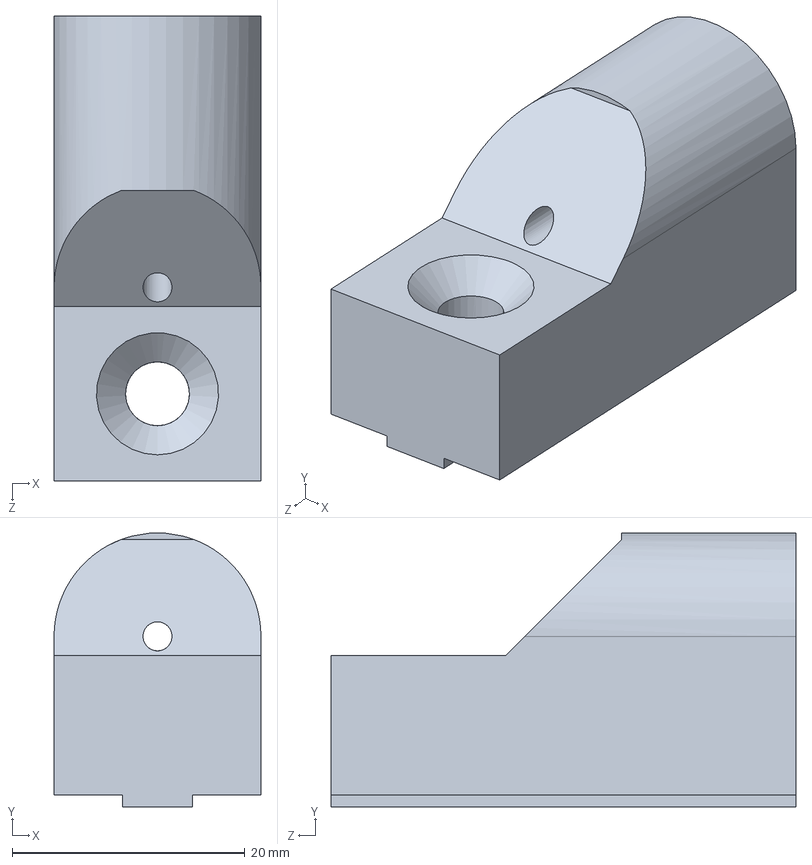
[picture p76: CAD file, 2022-02-02, last stored version]
models/v2/lvdt_holderP2.SLDPRT
17.8 x 23.5 x 40.0 mm
