Aightech/drvAMC/models/v2/profile20.SLDPRT

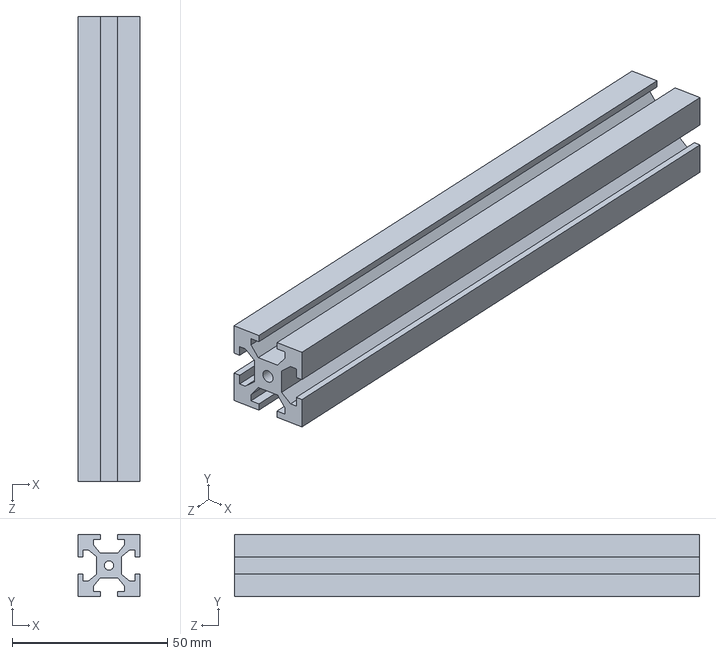
[picture p77: CAD file, 2022-02-02, last stored version]
models/v2/profile20.SLDPRT
20.0 x 20.0 x 150.0 mm
