Aightech/drvAMC/models/v2/profile30.SLDPRT

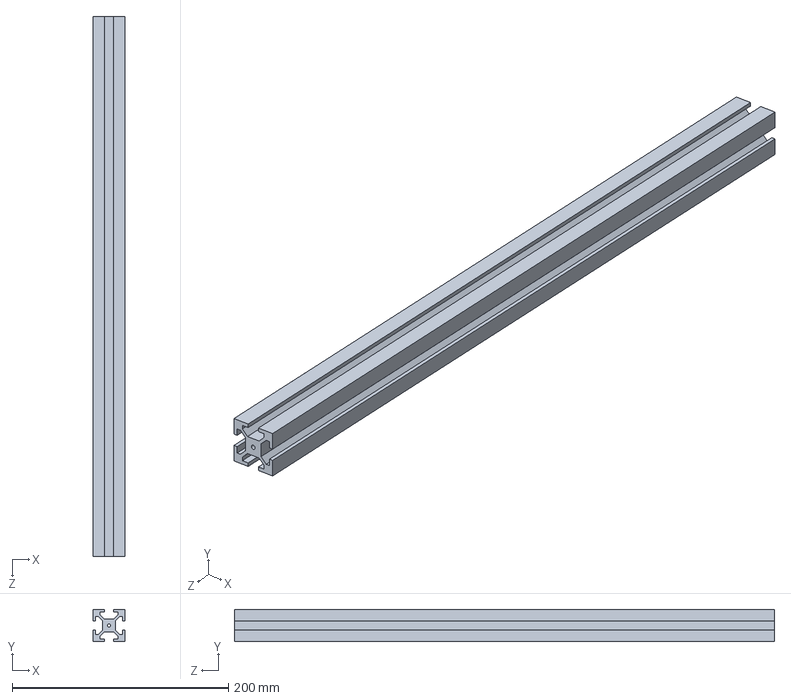
[picture p78: CAD file, 2022-02-02, last stored version]
models/v2/profile30.SLDPRT
30.0 x 30.0 x 500.0 mm
