Aightech/drvAMC/(list of files, cad)

Other CAD files:
models/screen.SLDPRT
models/profile30.SLDPRT
models/v2/screenHolderV2_top.STL
models/Assem1.SLDDRW
models/coil_end.STL
models/coil_holder.STL
models/frame.STL
models/guide.STL
models/ir_top.STL
models/irsensor_cache.STL
models/irsensor_tube.STL
models/magnet.STL
models/new/magnet_holder.STL
models/screen_holder.STL
models/v2/S302502.step
models/v2/S8025P02.SLDPRT
models/v2/bracke-holder-v2.STL
models/v2/bracke-holder.STL
models/v2/carter.STL
models/v2/driverHolder.STL
models/v2/lvdt_holderP2.STL
models/v2/lvdt_holderSLDPRT.STL
models/v2/screenDriverHolder.STL
models/v2/screenHolder.STL
