Aightech/drvAMC/src/uctrl_master/uctrl_master.ino

#define TEENSY_4
//#define IOT33
//#define UDP_MODE
#define VERSION 0x0200
#include "drvAMC.hpp"
#include "com.hpp"


#define DEBUG(x) Serial.print(x)
#define DEBUGF(x,y) Serial.print(x,y)
#define DEBUGLN(x) Serial.println(x)


byte buff[255];
int16_t pkgSize = 6;
byte vals[255] = {0x00, 0x00, 0x00, 0x00};
int i, nb = 0;

DrvAMC drvAMC;
Com com_interface;

bool first_dt = true;
int32_t dt;
int32_t last_t;
float mu[4];//mu,mup,n

bool compute_dt_stat()
{
  if (first_dt)
  {
    mu[0] = 0;
    mu[1] = 0;
    mu[2] = 0;
    mu[3] = 0;
    first_dt = false;
    last_t = micros();
  }
  else
  {
    dt = micros() - last_t;
    if (dt > 200)
    {
      mu[0] = (mu[0] * mu[2] + dt) / (mu[2] + 1);//iterative mean
      mu[1] = (mu[1] * mu[2] + dt * dt) / (mu[2] + 1);//iterative mean of square
      mu[2] = (mu[2]>50000)?0:mu[2]+1;//nb sample. reset to avoid huge multp&div 
      mu[3] = (dt > mu[3]) ? dt : mu[3];//max
      last_t = micros();
    }
    else
      return false;
  }
  return true;
}

void setup()
{
  Serial.begin(9600);
  //while (!Serial) {}
  Serial.println("OK");
  com_interface.begin(9600, 5000, 192, 168, 127, 150);
  Serial.println("OKi");

  drvAMC.begin();

}


void loop()
{
  int nn = com_interface.available();
  if (nn >= pkgSize)
  {
    if (compute_dt_stat())
    {
      com_interface.read(buff, pkgSize);
      switch (buff[0])
      {
        case 'c':// set current > 'c' | id | val0 | val1
          {
            drvAMC.set_current(*(int16_t*)(buff + 2));
            com_interface.write((uint8_t*)&pkgSize, 2);
            break;
          }
        case 'p':// get pos > 'p'
          {
            com_interface.write((uint8_t*)drvAMC.get_pos_ptr(), 2);
            break;
          }
        case 'x':// set current and get pos > 'x' | id | val0 | val1
          {
            drvAMC.set_current(*(int16_t*)(buff + 2));
            //Serial.println(*(int16_t*)(buff + 2));
            com_interface.write((uint8_t*)drvAMC.get_pos_ptr(), 2);
            break;
          }  
        case 'd':// get stat > 'd'
          {
            com_interface.write((uint8_t*)mu, 16);
            first_dt = true;
            break;
          }
      }
    }
  }


}
