Aightech/drvAMC/(commit log)

2022-02-09 working with var stiffness
    [drvAMC.cpp, main.cpp]
2022-04-29 refactor to make it only a AMC driver lib , deepscreen is a new repo
    [AVM90-30.STEP, Assem1.SLDASM, Assem1.SLDDRW, Assem2.SLDASM, S302502.step, S8025E02.STEP, S8025P02.SLDPRT, S8025P02.step]
2022-05-04 added mutex mechanism to ensure only one thread at once could use the driver
2022-05-25 refactor cmakelist
    [CMakeConfig.txt]
2022-06-14 added guidelines files to follow community standards
    [CMakeConfig.txt]
2022-07-19 fixed comcilent connection mode
    [drvAMC.cpp]
2022-07-27 Some log display fixes
    [drvAMC.cpp, drvAMC.hpp]
2022-08-09 refactor former driver class to driver setting com, and create a new driver class communicating with a uctrler interfacing the driver via pwm and dir gpio pins
    [CMakeConfig.txt]
2023-03-01 upgrade lib to match new com_client and strANSIseq + teensy code
    [CMakeConfig.txt]
2023-06-28 updated sublib
    [CMakeConfig.txt]
2024-02-28 refactor class parenting
    [CMakeConfig.txt]
2024-03-15 refactor and simplified sending and receiving functions, add reset feature
    [CMakeConfig.txt]
2024-05-30 updated libs
    [CMakeConfig.txt]
